jackkc7vlo/V12_Front_Panel_7_Inch_Zulkit/V12_Front_Panel_7_inch_Zulkit.FCStd

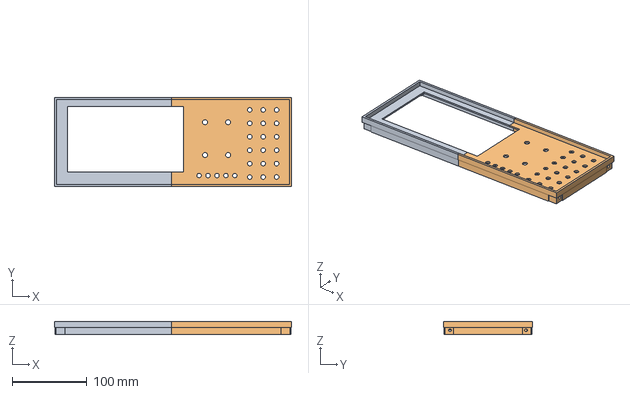
[picture p4: CAD file, 2026-10-18]
V12_Front_Panel_7_inch_Zulkit.FCStd
318.0 x 120.0 x 18.0 mm
Slice.0
Slice.1
