jackkc7vlo/V12_Front_Panel_7_Inch_Zulkit/V12_Front_Panel_7_inch_Zulkit-Slice.left.3mf

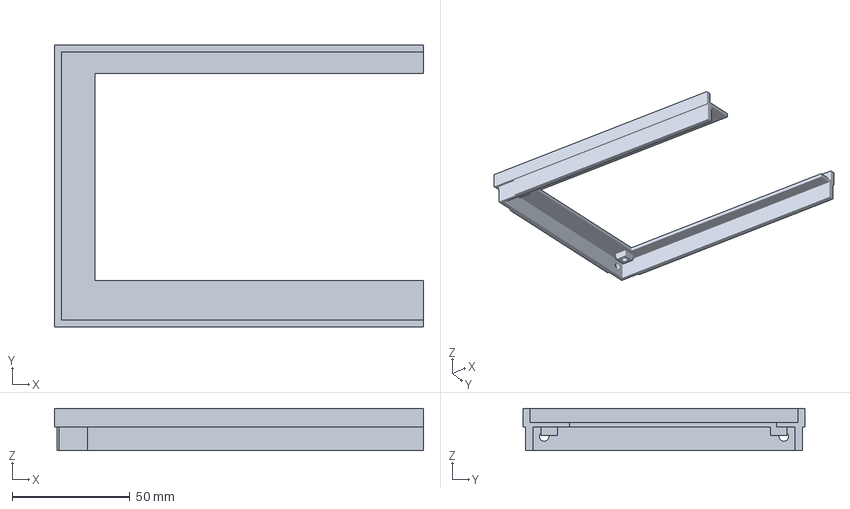
[picture p5: CAD file, 2026-10-18]
V12_Front_Panel_7_inch_Zulkit-Slice.left.3mf
157.0 x 120.0 x 18.0 mm
