jackkc7vlo/V12_Front_Panel_7_Inch_Zulkit/V12_Front_Panel_7_inch_Zulkit-GlueMounts.3mf

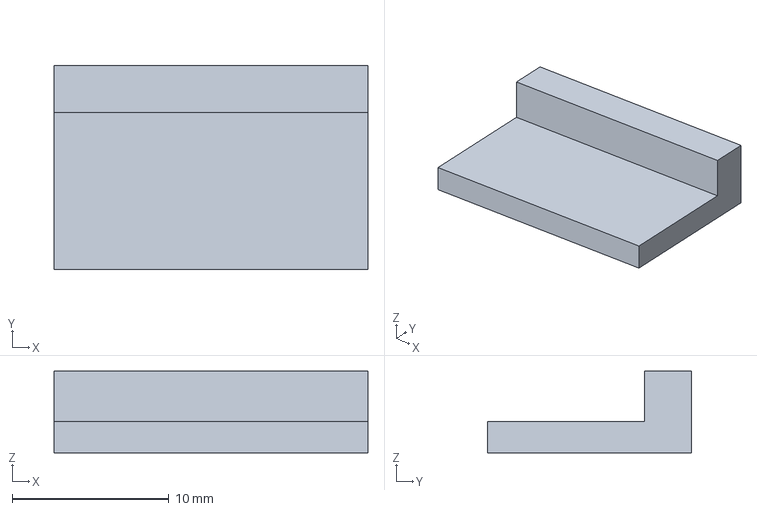
[picture p7: CAD file, 2026-10-18]
V12_Front_Panel_7_inch_Zulkit-GlueMounts.3mf
20.0 x 13.0 x 5.20 mm
