jackkc7vlo/V12_Front_Panel_7_Inch_Zulkit/(list of files, cad)

Other CAD files:
V12_Front_Panel_7_inch_Zulkit-GlueMounts.stl
V12_Front_Panel_7_inch_Zulkit-Slice.left.stl
V12_Front_Panel_7_inch_Zulkit-Slice.right.stl
