jackkc7vlo/V12_Front_Panel_7_Inch_Zulkit/(commit log)

2026-10-10 Created Basic Frame
2026-10-10 Added buttons
2026-10-12 Added Encoders
2026-10-13 Added Mounting Holes
2026-10-13 Added Encoder Divider
2026-10-18 Revise assembly instructions in README.md
    Reordered steps for better clarity and updated instructions for testing the keypad fit.
2026-10-18 Update README with additional parts links
    Added links for glue and inserts to the README.
